maxmlewa/FPGA_Step_Generator/sim/results/STEP_COUNTER_TB_Output.png

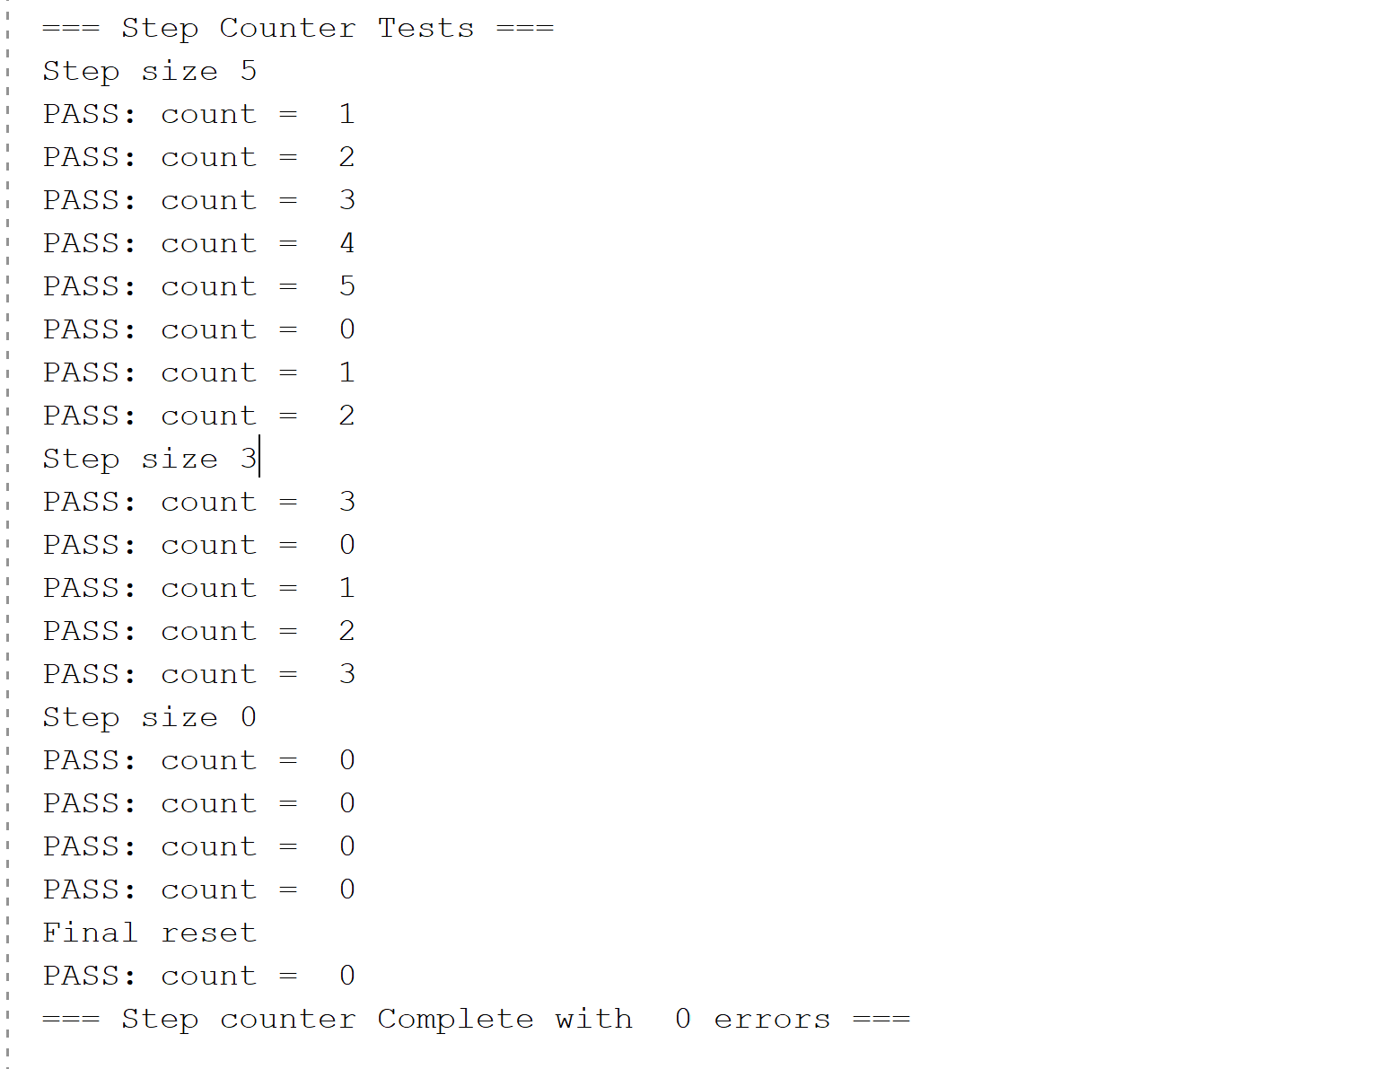
sim/results/STEP_COUNTER_TB_Output.png
