maxmlewa/FPGA_Step_Generator/sim/results/STEP_COUNTER_TB_Waveform.png

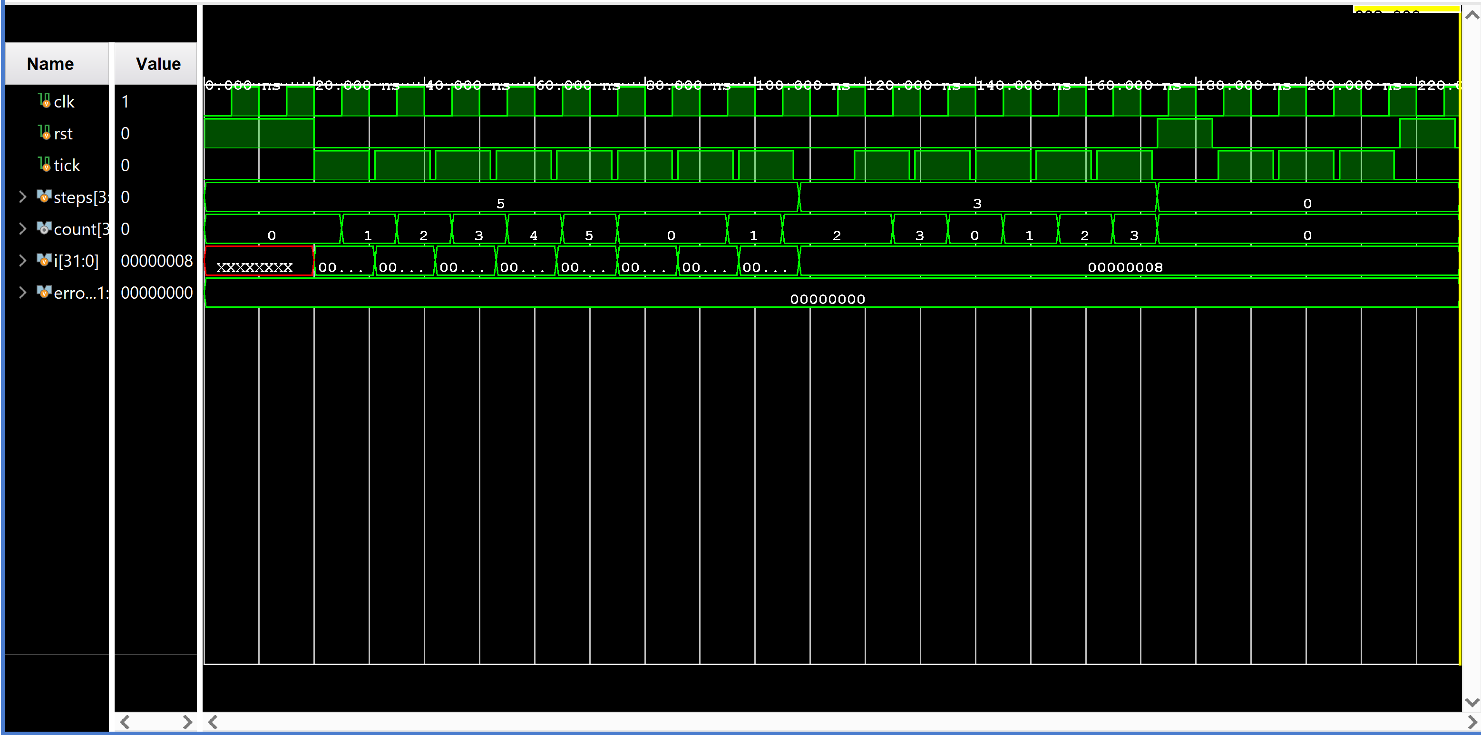
sim/results/STEP_COUNTER_TB_Waveform.png
