maxmlewa/FPGA_Step_Generator/sim/results/STEP_SELECTOR_TB_Waveform.png

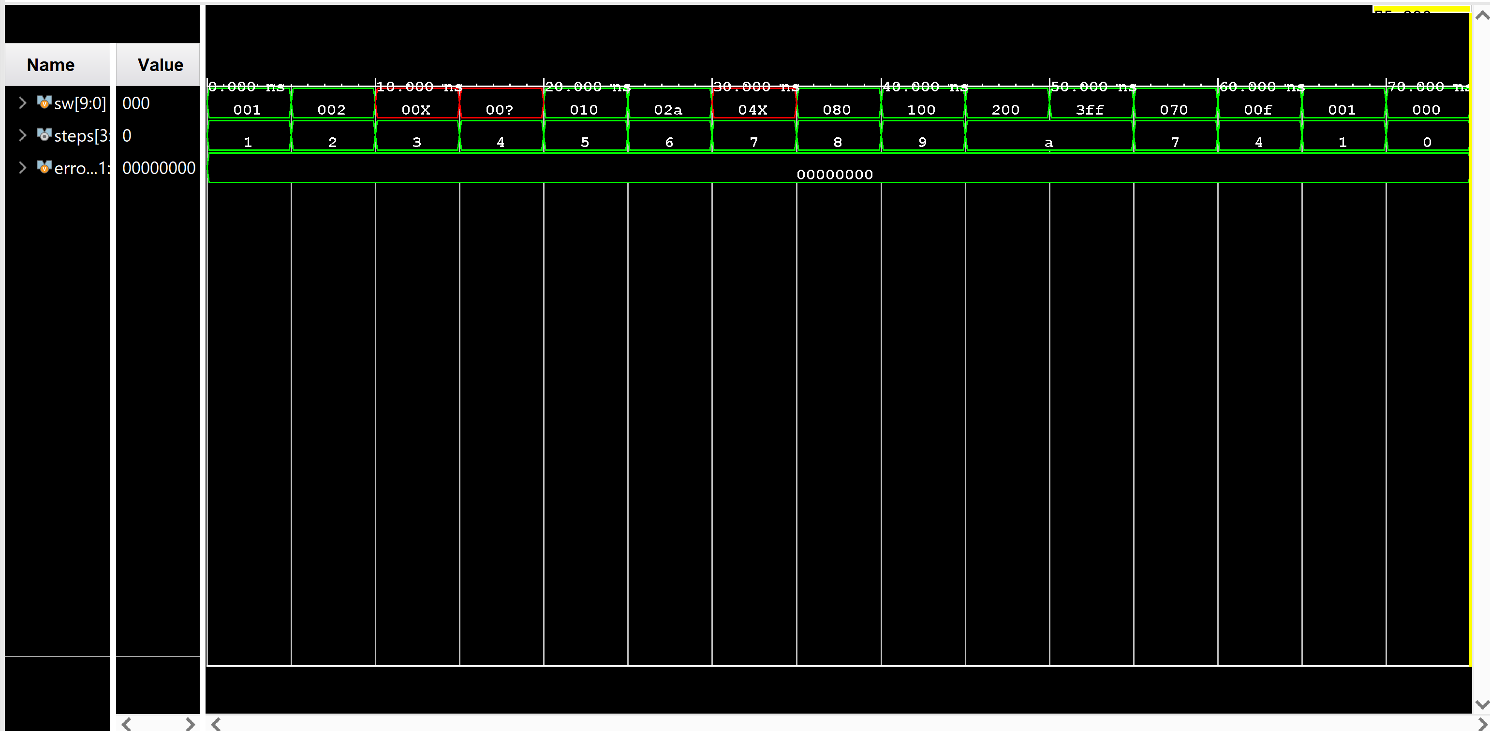
sim/results/STEP_SELECTOR_TB_Waveform.png
