maxmlewa/FPGA_Step_Generator/sim/results/DEBOUNCED_EDGE_DETECTOR_Realistic_Waveform.png

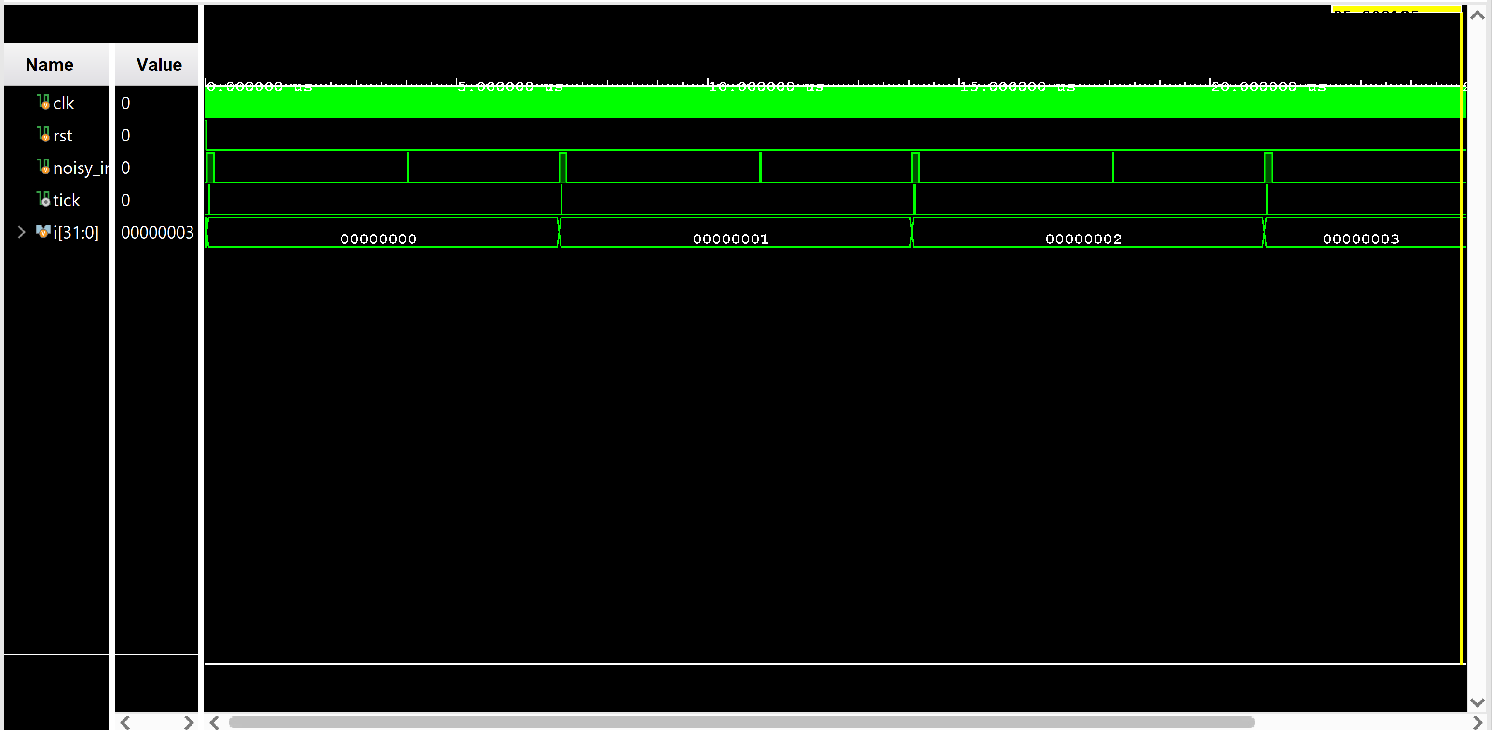
sim/results/DEBOUNCED_EDGE_DETECTOR_Realistic_Waveform.png
