maxmlewa/FPGA_Step_Generator/sim/results/SEVEN_SEG_TB_OUTPUT.png

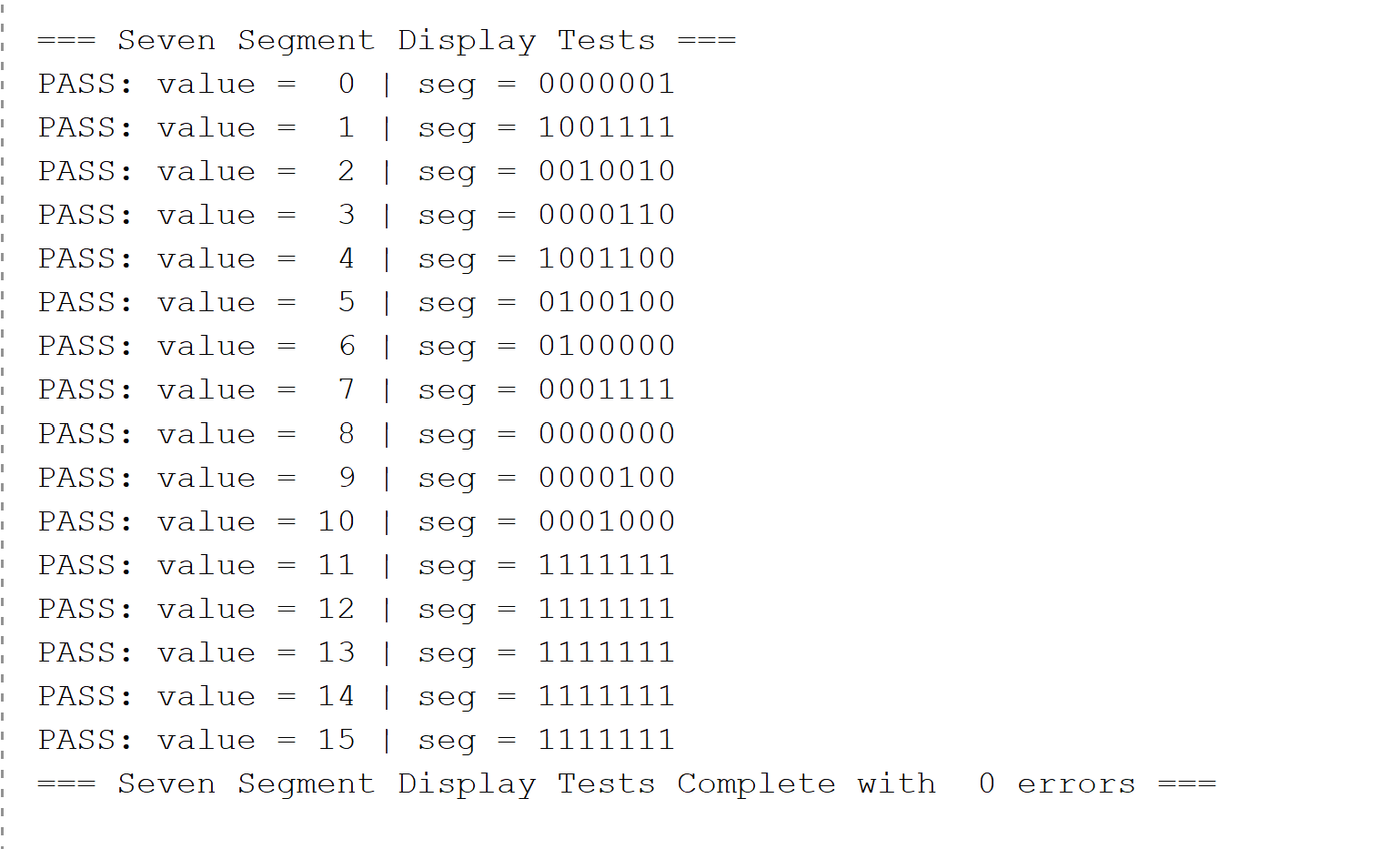
sim/results/SEVEN_SEG_TB_OUTPUT.png
