maxmlewa/FPGA_Step_Generator/sim/results/SEVEN_SEG_TB_Waveform.png

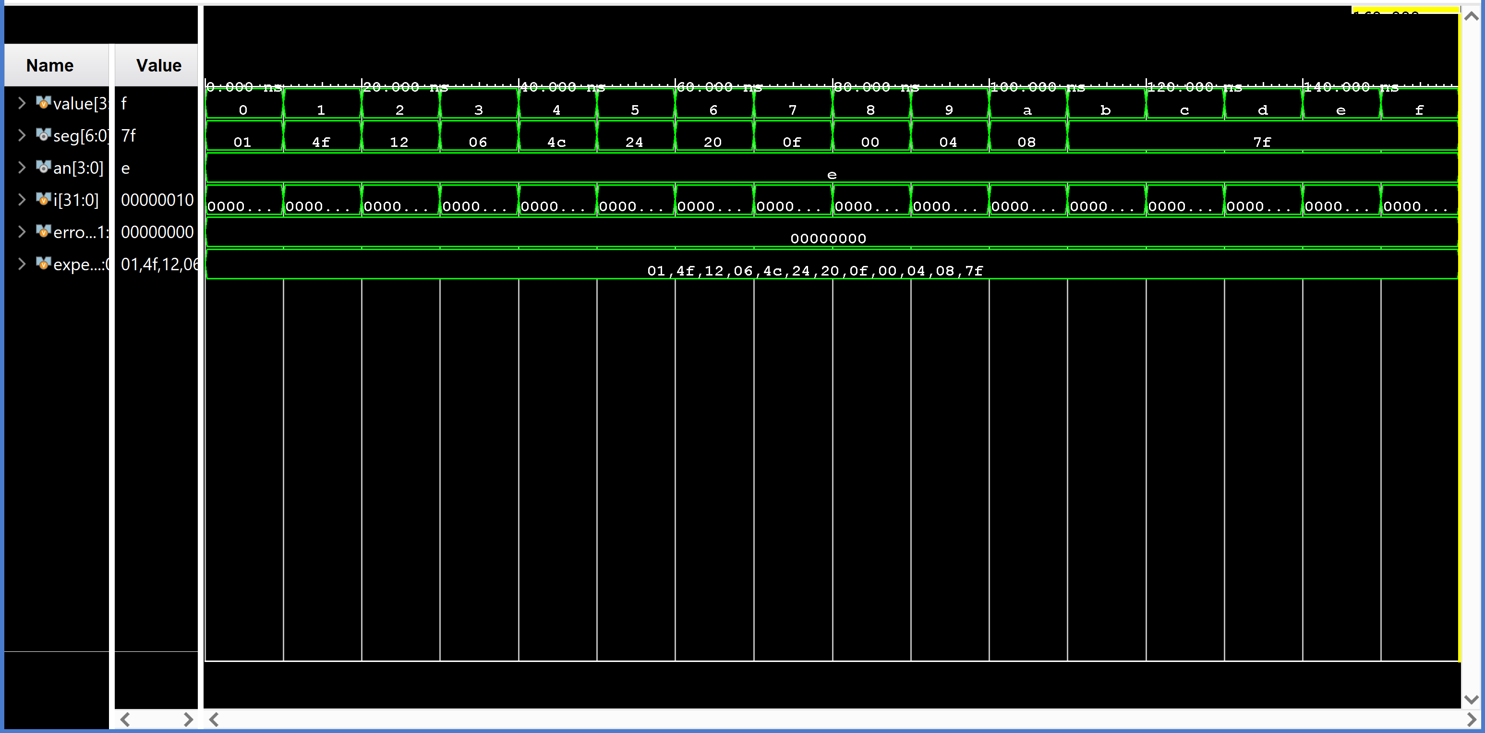
sim/results/SEVEN_SEG_TB_Waveform.png
