maxmlewa/FPGA_Step_Generator/sim/results/SYSTEM_TB_Waveform.png

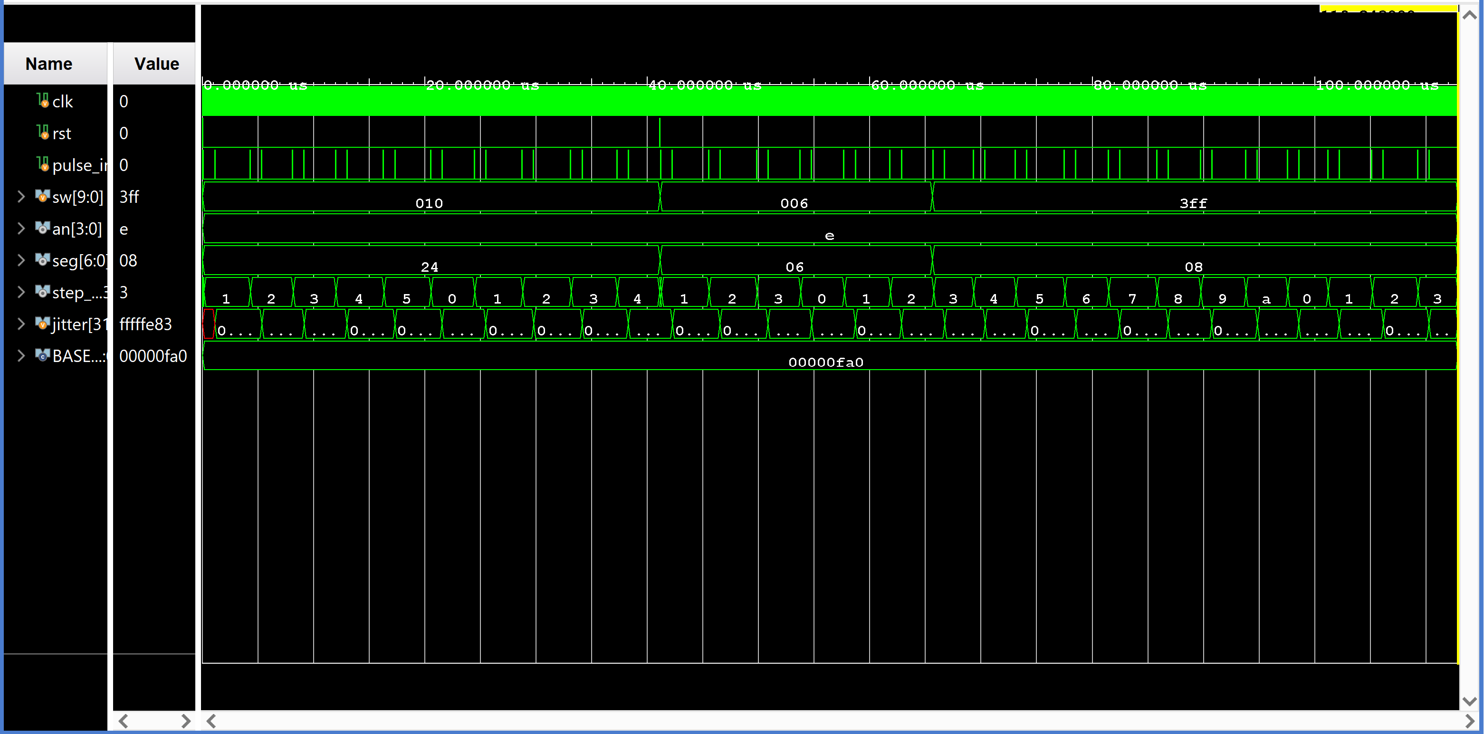
sim/results/SYSTEM_TB_Waveform.png
