maxmlewa/FPGA_Step_Generator/(commit log)

2025-07-29 Corrected Step Selector Testbench with finish statement
    [testbench_step_selector.v]
2025-07-30 Corrected step counter behavior to count up to max_steps
    [step_counter.v, testbench_step_counter.v, testbench_top_module.v, top_module_step_gen.v]
2025-07-31 Update README.md
    added Transistor Curve Tracer Block Diagram
2025-07-31 Update README.md
    Switching Times
